JackGuo-design/cpu-jet-engine/hardware/control-box-v2.3mf

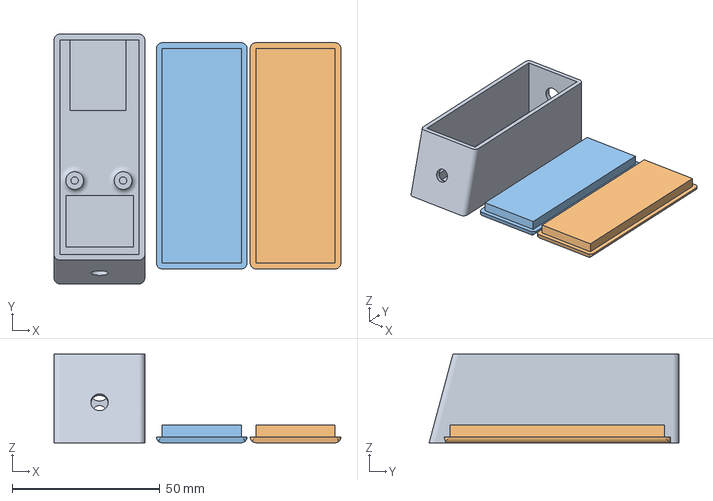
[picture p5: CAD file, 2026-11-07]
hardware/control-box-v2.3mf
97.2 x 84.6 x 30.0 mm
喷气发动机动力控制盒 v2_1
喷气发动机动力控制盒 v2_2 x 2
