JackGuo-design/cpu-jet-engine/docs/assets/wiring-diagram.zh-CN.png

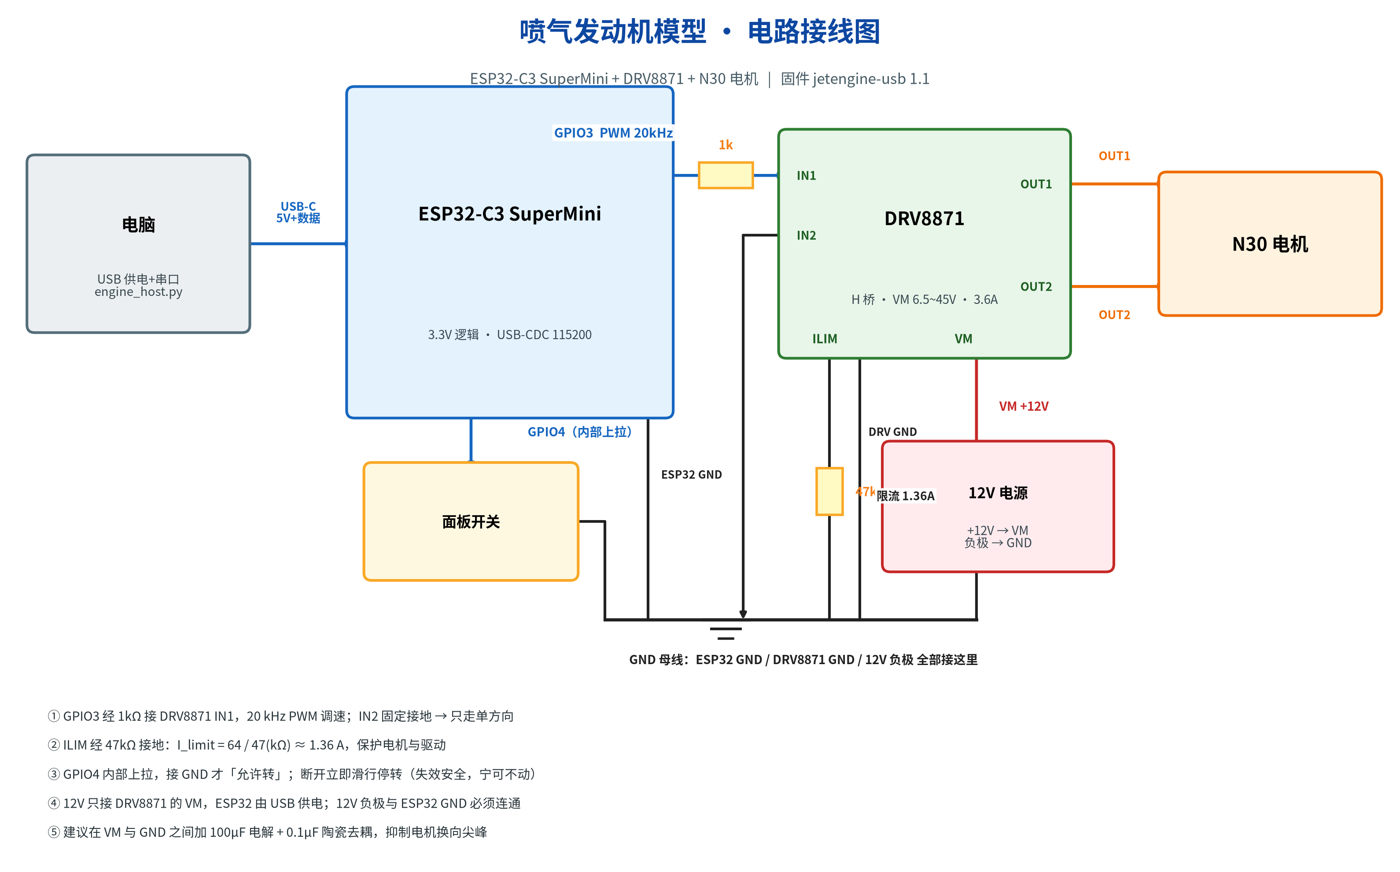
docs/assets/wiring-diagram.zh-CN.png
